PikoPikoFactory/PikoPikoBitsFM_YM2143/Hardware/PikoPikoBitsFM_schematic.pdf

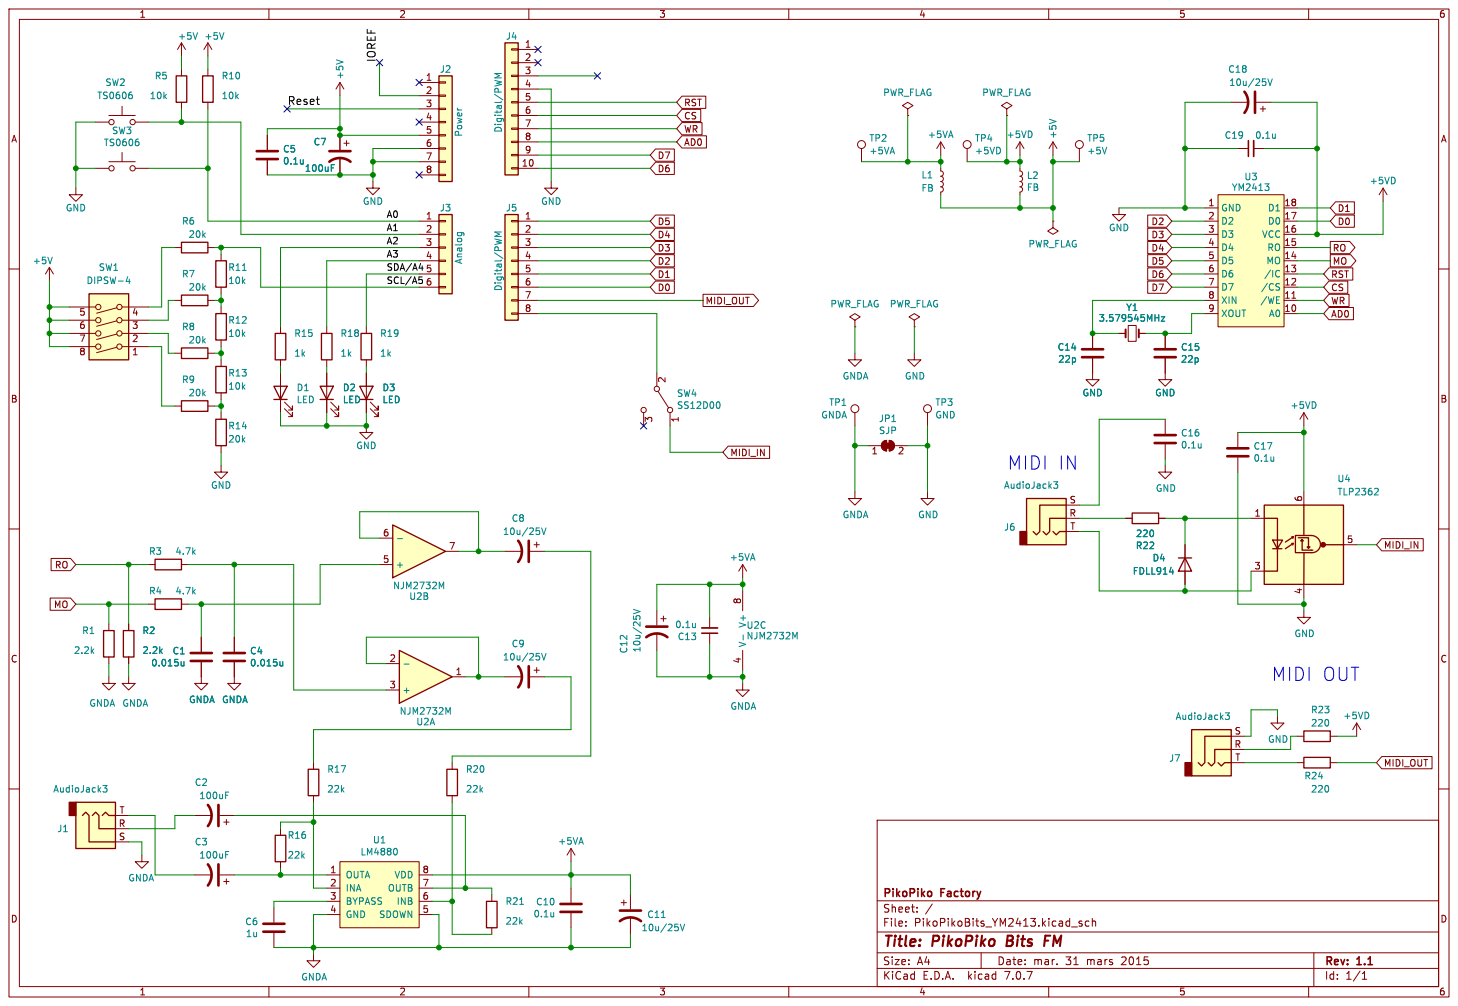
[picture p6: page 1]

Id: 1/1 Title: PikoPiko Bits FM
